avnguyen08/Air_Piston_Control/workspace_1.18.1/README.md

## Source Code for Air Piston Controller
- Upload firmware to STM32G4
