avnguyen08/Air_Piston_Control/Air_Piston_Oil_Control/MAX6817EUT_T.step

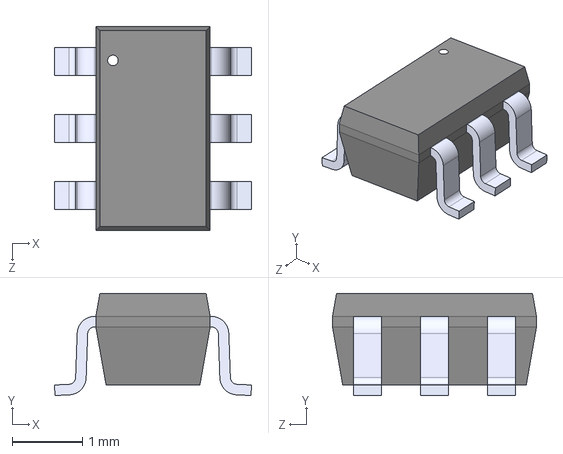
[picture p1: CAD file, 2025-06-28]
Air_Piston_Oil_Control/MAX6817EUT_T.step
2.80 x 1.45 x 2.90 mm
