avnguyen08/Air_Piston_Control/Air_Piston_Oil_Control/Air_Piston_Oil_Control.kicad_pcb

## KiCad design Air_Piston_Oil_Control/Air_Piston_Oil_Control.kicad_pcb (2025-07-28)

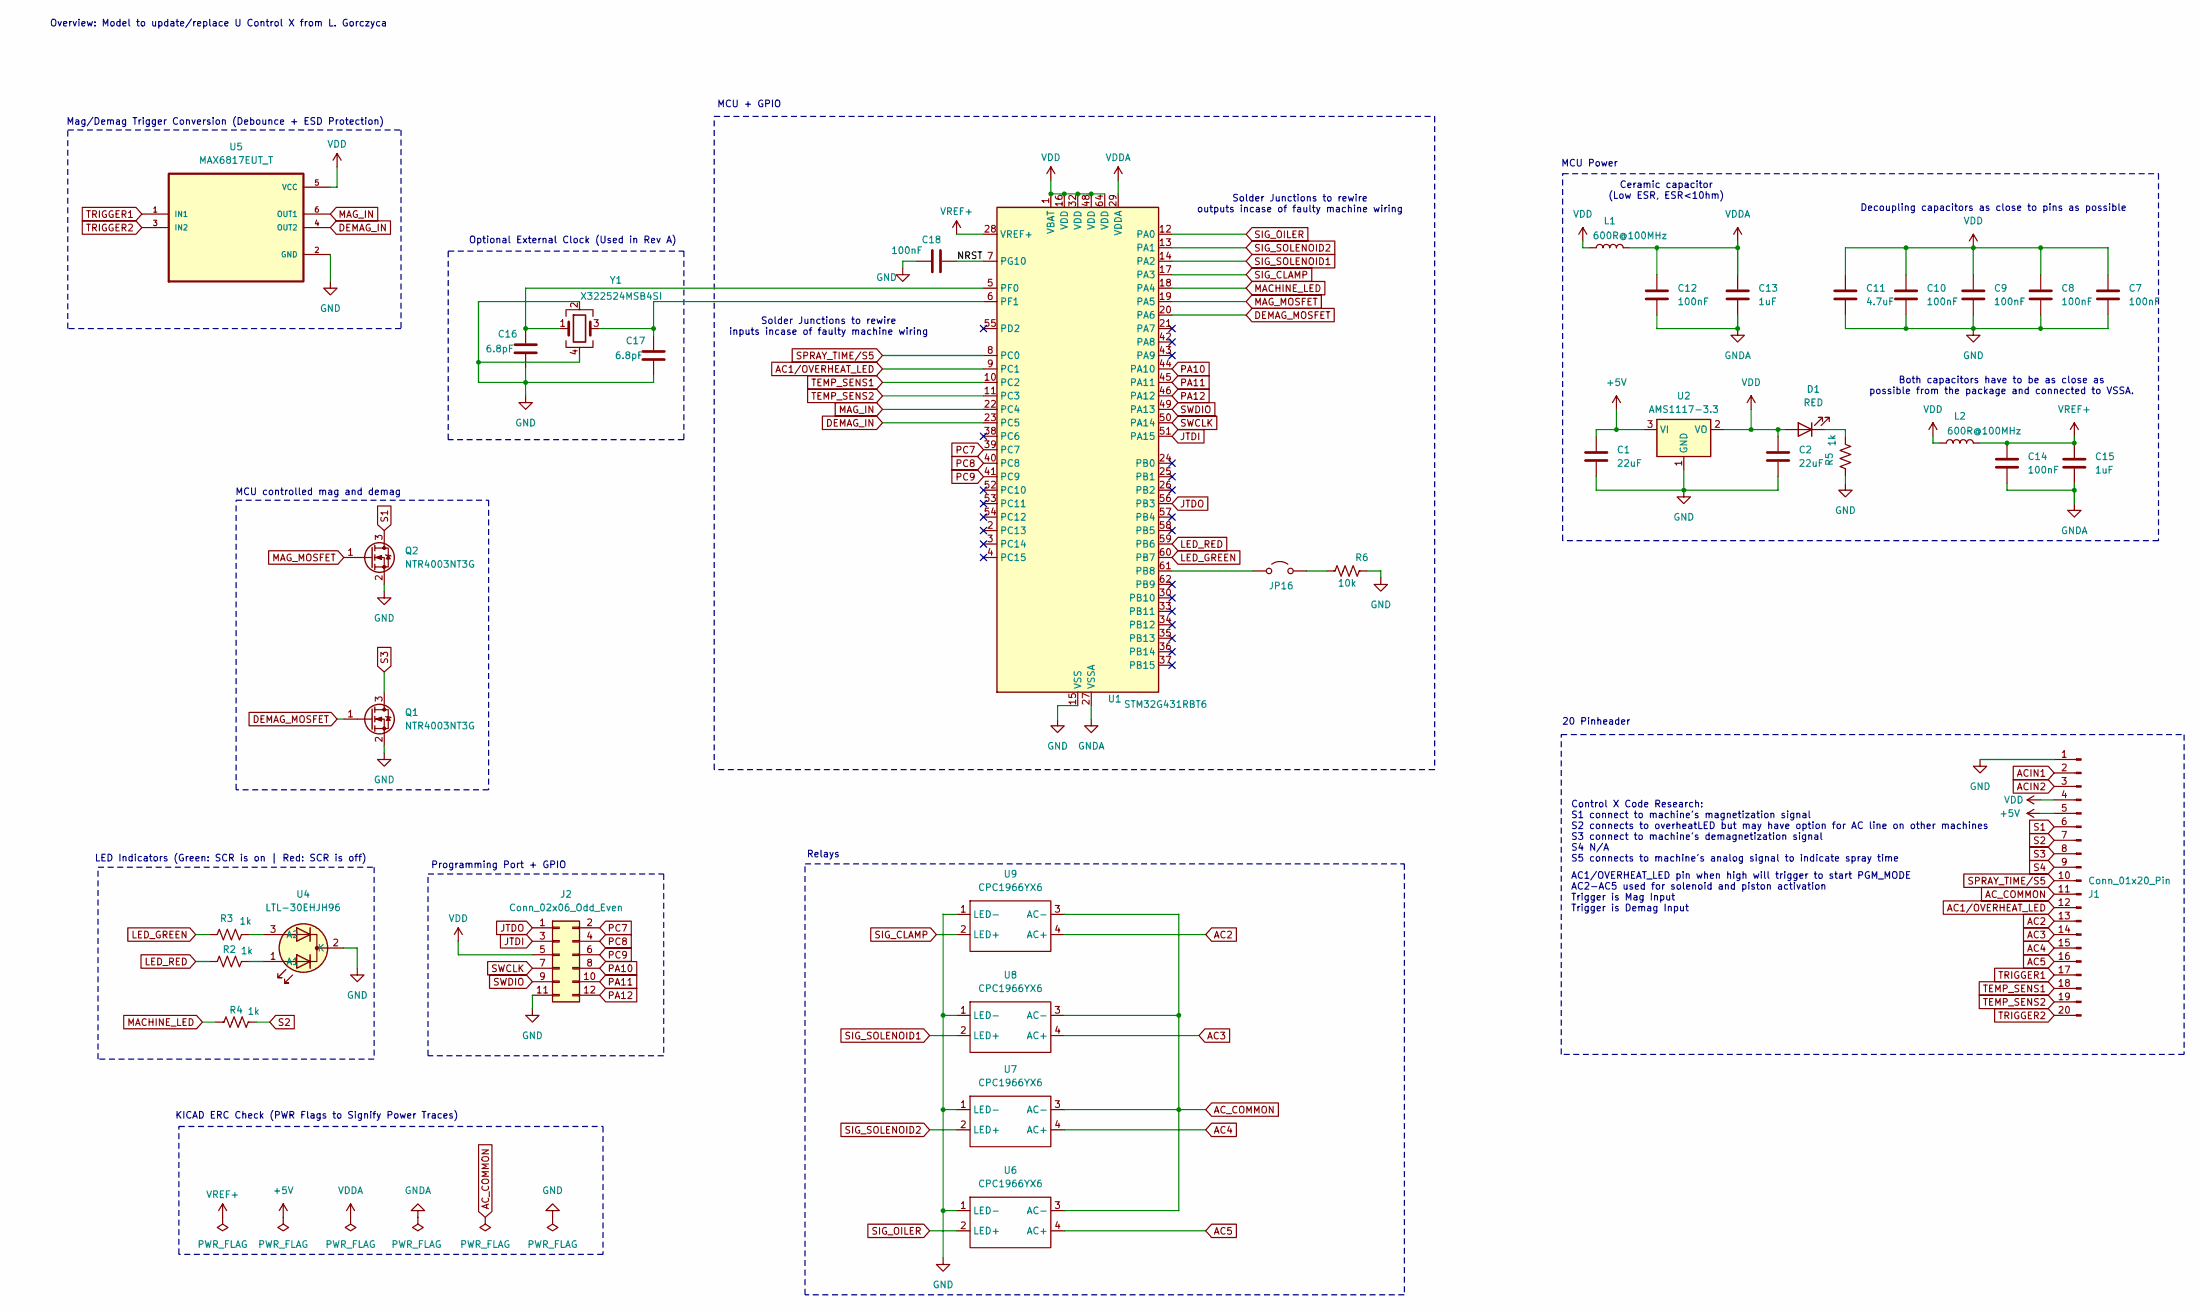
[picture p2: schematic Air_Piston_Oil_Control.kicad_sch, U Control]

Parts:
C1, C2: 22uF; C_0805_2012Metric
C7, C8, C9, C10, C12, C14, C18: 100nF; C_0805_2012Metric
C11: 4.7uF; C_0805_2012Metric
C13, C15: 1uF; C_0805_2012Metric
C16, C17: 6.8pF; C_0805_2012Metric
D1: RED; LED_0805_2012Metric
J1: Conn_01x20_Pin; Molex_SL_171971-0020_1x20_P2.54mm_Vertical
J2: Conn_02x06_Odd_Even; PinHeader_2x06_P2.54mm_Vertical
JP16: Jumper_2_Open; PinHeader_1x02_P2.54mm_Vertical
L1, L2: 600R@100MHz; L_0805_2012Metric
Q1, Q2: NTR4003NT3G
R2, R3, R4, R5: 1k; R_0805_2012Metric
R6: 10k; R_0805_2012Metric
U1: STM32G431RBT6; LQFP-64_10x10mm_P0.5mm
U2: AMS1117-3.3; SOT-223-3_TabPin2
U4: LTL-30EHJH96
U5: MAX6817EUT_T
U6, U7, U8, U9: CPC1966YX6
Y1: X322524MSB4SI; Crystal_SMD_3225-4Pin_3.2x2.5mm

Connections:
+5V: C1.1, J1.5, U2.3 (VI)
/NRST: C18.2, U1.7 (PG10)
AC1/OVERHEAT_LED: J1.12, U1.9 (PC1)
AC2: J1.13, U9.4 (AC+)
AC3: J1.14, U8.4 (AC+)
AC4: J1.15, U7.4 (AC+)
AC5: J1.16, U6.4 (AC+)
ACIN1: J1.2
ACIN2: J1.3
AC_COMMON: J1.11, U6.3 (AC-), U7.3 (AC-), U8.3 (AC-), U9.3 (AC-)
DEMAG_IN: U1.23 (PC5), U5.4 (OUT2)
DEMAG_MOSFET: Q1.1 (G), U1.20 (PA6)
GND: C1.2, C2.2, C7.2, C8.2, C9.2, C10.2, C11.2, C16.2, C17.2, C18.1, J1.1, J2.11, Q1.2 (S), Q2.2 (S), R5.1, R6.1, U1.15 (VSS), U1.31 (VSS), U1.47 (VSS), U1.63 (VSS), U2.1 (GND), U4.2 (K), U5.2 (GND), U6.1 (LED-), U7.1 (LED-), U8.1 (LED-), U9.1 (LED-), Y1.2, Y1.4
GNDA: C12.2, C13.2, C14.2, C15.2, U1.27 (VSSA)
JTDI: J2.3, U1.51 (PA15)
JTDO: J2.1, U1.56 (PB3)
LED_GREEN: R3.1, U1.60 (PB7)
LED_RED: R2.1, U1.59 (PB6)
MACHINE_LED: R4.1, U1.18 (PA4)
MAG_IN: U1.22 (PC4), U5.6 (OUT1)
MAG_MOSFET: Q2.1 (G), U1.19 (PA5)
unnamed: D1.1 (K), R5.2
unnamed: JP16.1 (A), U1.61 (PB8)
unnamed: JP16.2 (B), R6.2
unnamed: C16.1, U1.5 (PF0), Y1.1
unnamed: C17.1, U1.6 (PF1), Y1.3
unnamed: R2.2, U4.1 (A1)
unnamed: R3.2, U4.3 (A2)
PA10: J2.8, U1.44 (PA10)
PA11: J2.10, U1.45 (PA11)
PA12: J2.12, U1.46 (PA12)
PC7: J2.2, U1.39 (PC7)
PC8: J2.4, U1.40 (PC8)
PC9: J2.6, U1.41 (PC9)
S1: J1.6, Q2.3 (D)
S2: J1.7, R4.2
S3: J1.8, Q1.3 (D)
S4: J1.9
SIG_CLAMP: U1.17 (PA3), U9.2 (LED+)
SIG_OILER: U1.12 (PA0), U6.2 (LED+)
SIG_SOLENOID1: U1.14 (PA2), U8.2 (LED+)
SIG_SOLENOID2: U1.13 (PA1), U7.2 (LED+)
SPRAY_TIME/S5: J1.10, U1.8 (PC0)
SWCLK: J2.7, U1.50 (PA14)
SWDIO: J2.9, U1.49 (PA13)
TEMP_SENS1: J1.18, U1.10 (PC2)
TEMP_SENS2: J1.19, U1.11 (PC3)
TRIGGER1: J1.17, U5.1 (IN1)
TRIGGER2: J1.20, U5.3 (IN2)
VDD: C2.1, C7.1, C8.1, C9.1, C10.1, C11.1, D1.2 (A), J1.4, J2.5, L1.2, L2.1, U1.1 (VBAT), U1.16 (VDD), U1.32 (VDD), U1.48 (VDD), U1.64 (VDD), U2.2 (VO), U5.5 (VCC)
VDDA: C12.1, C13.1, L1.1, U1.29 (VDDA)
VREF+: C14.1, C15.1, L2.2, U1.28 (VREF+)

Notes on the sheet:
MCU controlled mag and demag
Control X Code Research: S1 connect to machine's magnetization signal S2 connects to overheatLED but may have option for AC line on other machines S3 connect to machine's demagnetization signal S4 N/A S5 connects to machine's analog signal to indicate spray time
20 Pinheader
MCU + GPIO
KICAD ERC Check (PWR Flags to Signify Power Traces)
Relays
Solder Junctions to rewire inputs incase of faulty machine wiring
Decoupling capacitors as close to pins as possible
Optional External Clock (Used in Rev A)
AC1/OVERHEAT_LED pin when high will trigger to start PGM_MODE AC2-AC5 used for solenoid and piston activation Trigger is Mag Input Trigger is Demag Input
Solder Junctions to rewire outputs incase of faulty machine wiring
MCU Power
Mag/Demag Trigger Conversion (Debounce + ESD Protection)
Both capacitors have to be as close as possible from the package and connected to VSSA.
Ceramic capacitor (Low ESR, ESR<10hm)
Programming Port + GPIO
LED Indicators (Green: SCR is on | Red: SCR is off)
Overview: Model to update/replace U Control X from L. Gorczyca

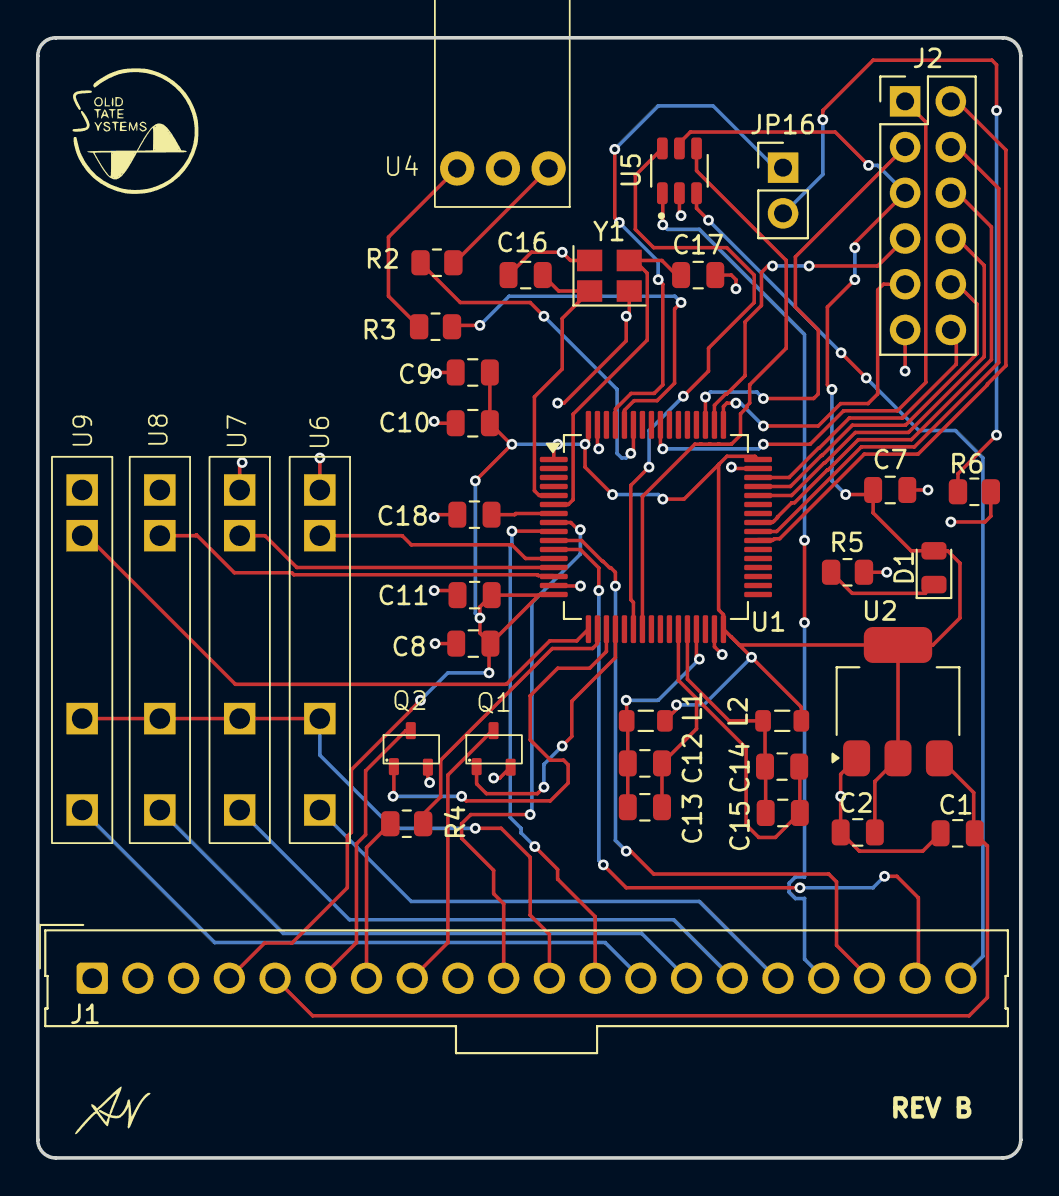
[picture p3: board Air_Piston_Oil_Control.kicad_pcb from above]

Board: 2 copper layers, 54.6 x 62.2 mm, 36 parts (0 on the bottom side), 49 nets.
