avnguyen08/Air_Piston_Control/workspace_1.18.1/air_piston/Core/Src/main.c

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
/* Includes ------------------------------------------------------------------*/
#include "main.h"

ADC_HandleTypeDef hadc1;

/* USER CODE BEGIN PV */

uint16_t Time_Delay1;
int Time_Delay2;
int D_Time;
int T_Fact=3; // MS/Step for PISS delay
int W_Time=600; // MS Wait time for shot delays and other timings


int Temp_Sensor1;
int Temp_Sensor2;

int Trigger1=10;
int Trigger2=19;

int SCR_STATUS;

// Buss Bar Sensor ( Future )
float MAX_TEMP = 38.0; // F 102.2 Shutdowm point in C.
float COOL_TEMP = 34.0; // F 96.8 Min Temp to Re-enable Circuit

/* USER CODE END PV */

void SystemClock_Config(void);
static void MX_GPIO_Init(void);
static void MX_ADC1_Init(void);
/* USER CODE BEGIN PFP */
uint16_t analogRead(uint32_t channel);
void Std_Mag();
void AutoMag();
void Mag_Shot();
void Demag();
void Water_On();
void Water_Off();
void Clamp();
void UnClamp();
void Piss();
void Temp_Check();
void SCR_ON();
void SCR_OFF();
void PGM_MODE();
void MAG_SETUP();
/* USER CODE END PFP */

/**
  * @brief  The application entry point.
  * @retval int
  */
int main(void)
{

  /* MCU Configuration--------------------------------------------------------*/

  /* Reset of all peripherals, Initializes the Flash interface and the Systick. */
  HAL_Init();

  /* Configure the system clock */
  SystemClock_Config();

  /* Initialize all configured peripherals */
  MX_GPIO_Init();
  MX_ADC1_Init();
  /* USER CODE BEGIN 2 */
//  HAL_Delay(100);
  SCR_OFF();  // Make sure that we assume that it is overheated at power up!

	HAL_GPIO_WritePin(RED_LED_GPIO_Port, RED_LED_Pin, GPIO_PIN_SET); // Red LED on
	HAL_GPIO_WritePin(GREEN_LED_GPIO_Port, GREEN_LED_Pin, GPIO_PIN_RESET); // Green LED on
	HAL_Delay(1000);
	HAL_GPIO_WritePin(RED_LED_GPIO_Port, RED_LED_Pin, GPIO_PIN_SET); // Red LED on
	HAL_GPIO_WritePin(GREEN_LED_GPIO_Port, GREEN_LED_Pin, GPIO_PIN_SET); // Green LED on
	HAL_Delay(1000);
	HAL_GPIO_WritePin(RED_LED_GPIO_Port, RED_LED_Pin, GPIO_PIN_RESET); // Red LED off
	HAL_GPIO_WritePin(GREEN_LED_GPIO_Port, GREEN_LED_Pin, GPIO_PIN_SET); // Green LED on
	HAL_Delay(1000);
	HAL_GPIO_WritePin(RED_LED_GPIO_Port, RED_LED_Pin, GPIO_PIN_RESET); // Red LED off
	HAL_GPIO_WritePin(GREEN_LED_GPIO_Port, GREEN_LED_Pin, GPIO_PIN_RESET); // Green LED on
  /* USER CODE END 2 */

  /* Infinite loop */
  /* USER CODE BEGIN WHILE */
  while (1)
  {
	  Time_Delay1 = analogRead(6);
	    D_Time=(Time_Delay1*T_Fact);

	    Temp_Check();
	    if(SCR_STATUS!=0){
	      if((HAL_GPIO_ReadPin(Mag_In_GPIO_Port, Mag_In_Pin) == GPIO_PIN_RESET)&&(Time_Delay1>0)){
	        AutoMag(); // Magnatize
	      }
	      if((HAL_GPIO_ReadPin(Demag_In_GPIO_Port, Demag_In_Pin) == GPIO_PIN_RESET)&&(Time_Delay1>0)){
	        Demag(); // De-Magnatize
	      }
	      if((HAL_GPIO_ReadPin(Mag_In_GPIO_Port, Mag_In_Pin) == GPIO_PIN_RESET)&&(Time_Delay1==0)){
	        Std_Mag(); // Magnatize
	      }

	    }
	    if(HAL_GPIO_ReadPin(AC1_Over_Heat_LED_GPIO_Port, AC1_Over_Heat_LED_Pin) == GPIO_PIN_SET){
	      PGM_MODE();
	    }
	    if((SCR_STATUS==0)){
	    	HAL_GPIO_WritePin(GREEN_LED_GPIO_Port, GREEN_LED_Pin, GPIO_PIN_RESET); // Green LED off
	    	HAL_GPIO_WritePin(RED_LED_GPIO_Port, RED_LED_Pin, GPIO_PIN_SET); // Red LED on
	    }
	    if((SCR_STATUS==1)){
	    	HAL_GPIO_WritePin(GREEN_LED_GPIO_Port, GREEN_LED_Pin, GPIO_PIN_SET); // Green LED On
	    	HAL_GPIO_WritePin(RED_LED_GPIO_Port, RED_LED_Pin, GPIO_PIN_RESET); // Red LED Off
	    }
    /* USER CODE END WHILE */

    /* USER CODE BEGIN 3 */
  }
  /* USER CODE END 3 */
}

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
/* USER CODE BEGIN 4 */
uint16_t analogRead(uint32_t channel) {

	ADC_ChannelConfTypeDef sConfig = {0};
	if (channel == 6)
		sConfig.Channel = ADC_CHANNEL_6;
	else if (channel == 8)
		sConfig.Channel = ADC_CHANNEL_8;
	else if (channel == 9)
		sConfig.Channel = ADC_CHANNEL_9;
	else
		Error_Handler();

	sConfig.Rank = ADC_REGULAR_RANK_1;
	sConfig.SamplingTime = ADC_SAMPLETIME_2CYCLES_5;
	sConfig.SingleDiff = ADC_SINGLE_ENDED;
	sConfig.OffsetNumber = ADC_OFFSET_NONE;
	sConfig.Offset = 0;
	if (HAL_ADC_ConfigChannel(&hadc1, &sConfig) != HAL_OK)
	{
	Error_Handler();
	}
	HAL_ADC_Start(&hadc1);
	HAL_ADC_PollForConversion(&hadc1, 10);
	uint16_t val = HAL_ADC_GetValue(&hadc1);
	HAL_ADC_Stop(&hadc1);
	return val/4*3.3/5; // 4096->1024 and 5V to 3.3V conversion. legacy to new board
}
void Std_Mag()
{
 Clamp();
 HAL_Delay(1000);
 Mag_Shot();
 HAL_Delay(600);
 Mag_Shot();
 HAL_Delay(600);
 UnClamp();
}

void AutoMag()
{
  Clamp();
  HAL_Delay(W_Time); // Delay to get hand out of the way.
  Mag_Shot();
  HAL_Delay(W_Time); // Delay to prevent arcing.
  Water_On();
  HAL_Delay(500);
  Piss();
  Water_Off();
  Mag_Shot();
  HAL_Delay(W_Time);
  Mag_Shot();
  HAL_Delay(W_Time);
  HAL_Delay(W_Time);
  UnClamp();

}

#define Mag_Mosfet_Pin GPIO_PIN_5
#define Mag_Mosfet_GPIO_Port GPIOA
void Mag_Shot()
{
	HAL_GPIO_WritePin(Mag_Mosfet_GPIO_Port, Mag_Mosfet_Pin, GPIO_PIN_SET); // Mag Shot
	HAL_Delay(100); // Delay Time
	HAL_GPIO_WritePin(Mag_Mosfet_GPIO_Port, Mag_Mosfet_Pin, GPIO_PIN_RESET); // Mag Shot
}

void Demag()
{
   Clamp();
  HAL_Delay(1000);
  HAL_GPIO_WritePin(Demag_Mosfet_GPIO_Port, Demag_Mosfet_Pin, GPIO_PIN_SET); // DE-Mag Shot
  HAL_Delay(100); // Delay Time
  HAL_GPIO_WritePin(Mag_Mosfet_GPIO_Port, Mag_Mosfet_Pin, GPIO_PIN_RESET); // De-Mag Shot
  HAL_Delay(25000);
  UnClamp();
}

void Water_On()
{
	HAL_GPIO_WritePin(Sig_Solenoid1_GPIO_Port, Sig_Solenoid1_Pin, GPIO_PIN_RESET); // Water Solenoid 1
	HAL_GPIO_WritePin(Sig_Solenoid2_GPIO_Port, Sig_Solenoid2_Pin, GPIO_PIN_SET); // Water Solenoid 2
}

void Water_Off()
{
	HAL_GPIO_WritePin(Sig_Solenoid1_GPIO_Port, Sig_Solenoid1_Pin, GPIO_PIN_SET); // Water Solenoid 1
  HAL_GPIO_WritePin(Sig_Solenoid2_GPIO_Port, Sig_Solenoid2_Pin, GPIO_PIN_RESET); // Water Solenoid 2
}

void Clamp()
{
	HAL_GPIO_WritePin(Sig_Clamp_GPIO_Port, Sig_Clamp_Pin, GPIO_PIN_SET); // Clamp Head

}

void UnClamp()
{
	HAL_GPIO_WritePin(Sig_Clamp_GPIO_Port, Sig_Clamp_Pin, GPIO_PIN_RESET); // Clamp Head
}

void Piss()
{

	HAL_GPIO_WritePin(Sig_Oiler_GPIO_Port, Sig_Oiler_Pin, GPIO_PIN_SET); // Oiler On
	HAL_Delay(D_Time); // Delay Time
	HAL_GPIO_WritePin(Sig_Oiler_GPIO_Port, Sig_Oiler_Pin, GPIO_PIN_RESET);
}

void Temp_Check()
{
  Temp_Sensor1 = (analogRead(8)* 0.48828125);
  Temp_Sensor2 = (analogRead(9)* 0.48828125);
  if((Temp_Sensor1>=MAX_TEMP)||(Temp_Sensor2>=MAX_TEMP)){
    SCR_OFF();
  }
  if((Temp_Sensor1<=COOL_TEMP)&&(Temp_Sensor2<=COOL_TEMP)){
    SCR_ON();
  }
}

void SCR_ON(){
	HAL_GPIO_WritePin(Machine_LED_GPIO_Port, Machine_LED_Pin, GPIO_PIN_RESET);
	SCR_STATUS=1;
}

void SCR_OFF(){
	HAL_GPIO_WritePin(Machine_LED_GPIO_Port, Machine_LED_Pin, GPIO_PIN_SET);
	SCR_STATUS=0;
}

void PGM_MODE()
{
	//PGM Mode On
 while(HAL_GPIO_ReadPin(AC1_Over_Heat_LED_GPIO_Port, AC1_Over_Heat_LED_Pin) == GPIO_PIN_SET){

  Time_Delay1 = analogRead(6); //Spray Time
  D_Time=(Time_Delay1*T_Fact);

  Temp_Check();
  if(SCR_STATUS!=0){
    if((HAL_GPIO_ReadPin(Demag_In_GPIO_Port, Demag_In_Pin) == GPIO_PIN_RESET)&&(Time_Delay1>0)){
      Piss(); // Magnetize
      HAL_Delay(D_Time); // Return Delay Time
    }
    if(HAL_GPIO_ReadPin(Mag_In_GPIO_Port, Mag_In_Pin) == GPIO_PIN_RESET){
      Clamp();
      MAG_SETUP(); // De-Magnatize
      UnClamp();
    }
   }
 }
}

void MAG_SETUP()
{
   while(HAL_GPIO_ReadPin(AC1_Over_Heat_LED_GPIO_Port, AC1_Over_Heat_LED_Pin) == GPIO_PIN_SET){
     if(HAL_GPIO_ReadPin(Demag_In_GPIO_Port, Demag_In_Pin) == GPIO_PIN_RESET){
       break;
     }
     if(HAL_GPIO_ReadPin(Mag_In_GPIO_Port, Mag_In_Pin) == GPIO_PIN_RESET){
       Temp_Check();
       if(SCR_STATUS!=0){
         Mag_Shot();
       }
     }
   }
}

/* USER CODE END 4 */
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
