avnguyen08/Air_Piston_Control/workspace_1.18.1/air_piston/air_piston.ioc

Mcu.UserName=STM32G431RBTx
PA0.GPIO_Label=Sig_Oiler
PA0.Signal=GPIO_Output
PA1.GPIO_Label=Sig_Solenoid2
PA1.Signal=GPIO_Output
PA2.GPIO_Label=Sig_Solenoid1
PA2.Signal=GPIO_Output
PA3.GPIO_Label=Sig_Clamp
PA3.Signal=GPIO_Output
PA4.GPIO_Label=Machine_LED
PA4.Signal=GPIO_Output
PA5.GPIO_Label=Mag_Mosfet
PA5.Signal=GPIO_Output
PA6.GPIO_Label=Demag_Mosfet
PA6.Signal=GPIO_Output
PB6.GPIO_Label=GREEN_LED
PB6.Signal=GPIO_Output
PB7.GPIO_Label=RED_LED
PB7.Signal=GPIO_Output
PC0.GPIO_Label=Spray_Time
PC0.Signal=ADC1_IN6
PC1.GPIO_Label=AC1/Over_Heat_LED
PC1.Signal=GPIO_Input
PC2.GPIO_Label=Temp_Sensor1
PC2.Signal=ADC1_IN8
PC3.GPIO_Label=Temp_Sensor2
PC3.Signal=ADC1_IN9
PC4.GPIO_Label=Mag_In
PC4.Signal=GPIO_Input
PC5.GPIO_Label=Demag_In
PC5.Signal=GPIO_Input
PF0-OSC_IN.Signal=RCC_OSC_IN
PF1-OSC_OUT.Signal=RCC_OSC_OUT
