avnguyen08/Air_Piston_Control/workspace_1.18.1/air_piston/Core/Inc/main.h

#define Spray_Time_Pin GPIO_PIN_0
#define Spray_Time_GPIO_Port GPIOC
#define AC1_Over_Heat_LED_Pin GPIO_PIN_1
#define AC1_Over_Heat_LED_GPIO_Port GPIOC
#define Temp_Sensor1_Pin GPIO_PIN_2
#define Temp_Sensor1_GPIO_Port GPIOC
#define Temp_Sensor2_Pin GPIO_PIN_3
#define Temp_Sensor2_GPIO_Port GPIOC
#define Sig_Oiler_Pin GPIO_PIN_0
#define Sig_Oiler_GPIO_Port GPIOA
#define Sig_Solenoid2_Pin GPIO_PIN_1
#define Sig_Solenoid2_GPIO_Port GPIOA
#define Sig_Solenoid1_Pin GPIO_PIN_2
#define Sig_Solenoid1_GPIO_Port GPIOA
#define Sig_Clamp_Pin GPIO_PIN_3
#define Sig_Clamp_GPIO_Port GPIOA
#define Machine_LED_Pin GPIO_PIN_4
#define Machine_LED_GPIO_Port GPIOA
#define Mag_Mosfet_Pin GPIO_PIN_5
#define Mag_Mosfet_GPIO_Port GPIOA
#define Demag_Mosfet_Pin GPIO_PIN_6
#define Demag_Mosfet_GPIO_Port GPIOA
#define Mag_In_Pin GPIO_PIN_4
#define Mag_In_GPIO_Port GPIOC
#define Demag_In_Pin GPIO_PIN_5
#define Demag_In_GPIO_Port GPIOC
#define GREEN_LED_Pin GPIO_PIN_6
#define GREEN_LED_GPIO_Port GPIOB
#define RED_LED_Pin GPIO_PIN_7
#define RED_LED_GPIO_Port GPIOB
