avnguyen08/Air_Piston_Control/(commit log)

2025-07-17 manufacture ready
    [Base_Board.kicad_pcb, Base_Board.kicad_sch, bom.csv, designators.csv, positions.csv]
2025-07-28 Ver B manufacturing, removed solder pads
    [Air_Piston_Oil_Control.kicad_pcb, Air_Piston_Oil_Control.kicad_sch, bom.csv, designators.csv]
2025-08-18 adding stm32 firmware workspace
2025-08-30 syncing files
    [Base_Board.kicad_pcb]
