avnguyen08/Air_Piston_Control/(notices)

Notices in the files:
workspace_1.18.1/air_piston/Core/Inc/main.h:
Copyright (c) 2025 STMicroelectronics.
All rights reserved.
This software is licensed under terms that can be found in the LICENSE file
